xt-ml/shadow-claw-light-meter/pages/resources/assets/screenshots/tinyduino-lightmeter-workbench-731x1045.png

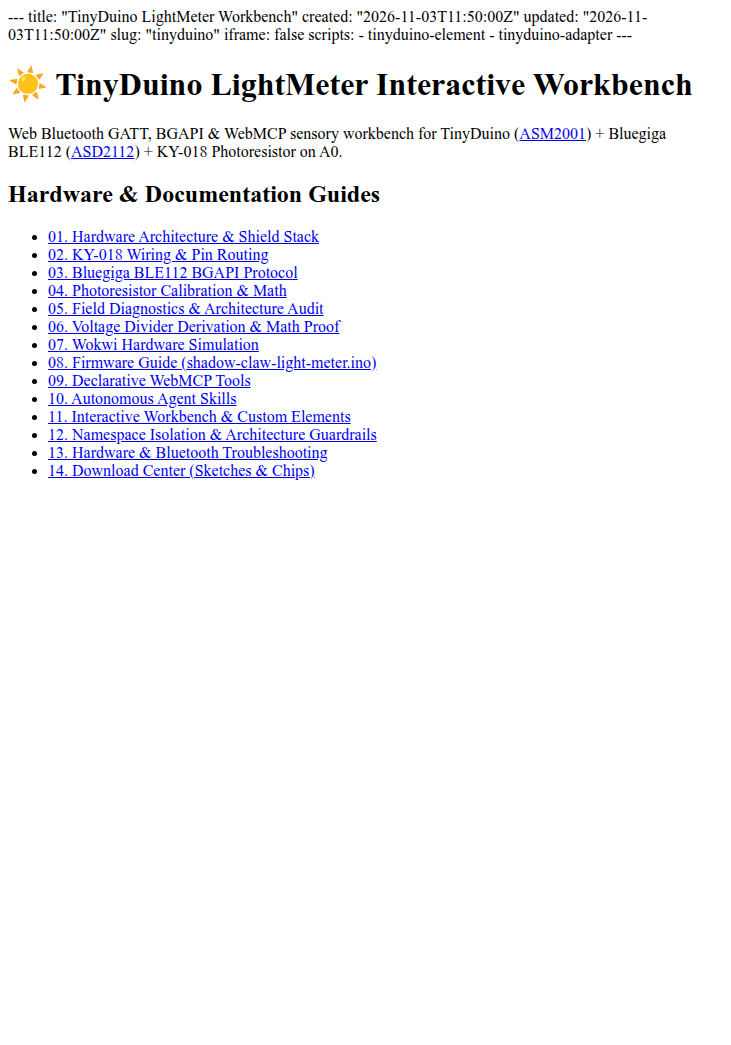
pages/resources/assets/screenshots/tinyduino-lightmeter-workbench-731x1045.png
